pauldubois98/Morscipio/README.md

# Morscipio
Un decodeur de morse portable.

=> Prix "Innovez" dans le Sciences et Vie Junior (SVJ) n°329

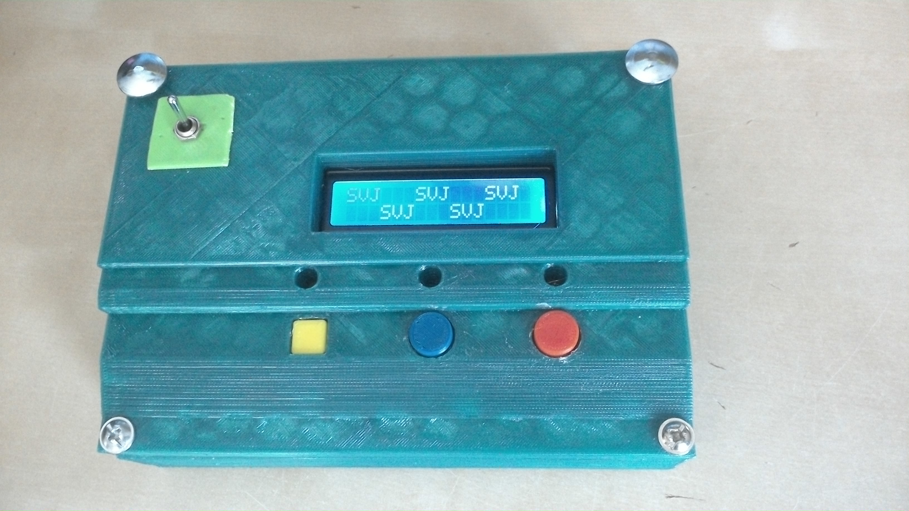
[picture p1: Fini/01.jpg]
final
