pauldubois98/Morscipio/Boitier/Bas0.jpg

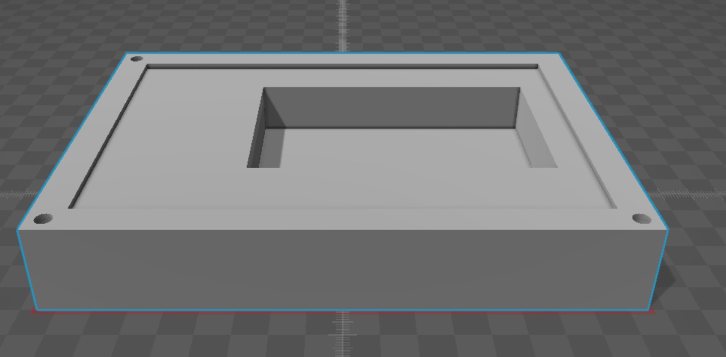
Boitier/Bas0.jpg
