pauldubois98/Morscipio/Boitier/Bas1.jpg

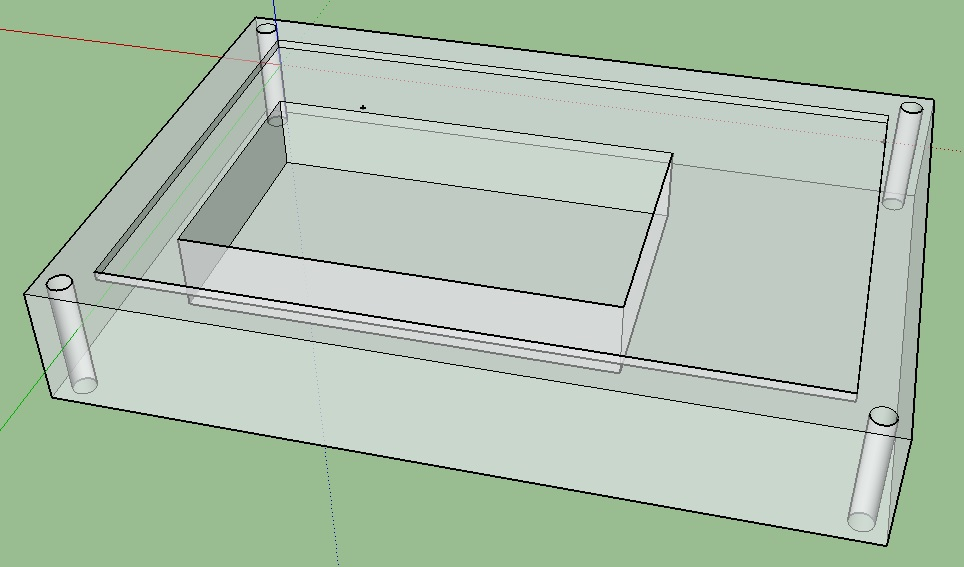
Boitier/Bas1.jpg
