pauldubois98/Morscipio/Boitier/Haut0.jpg

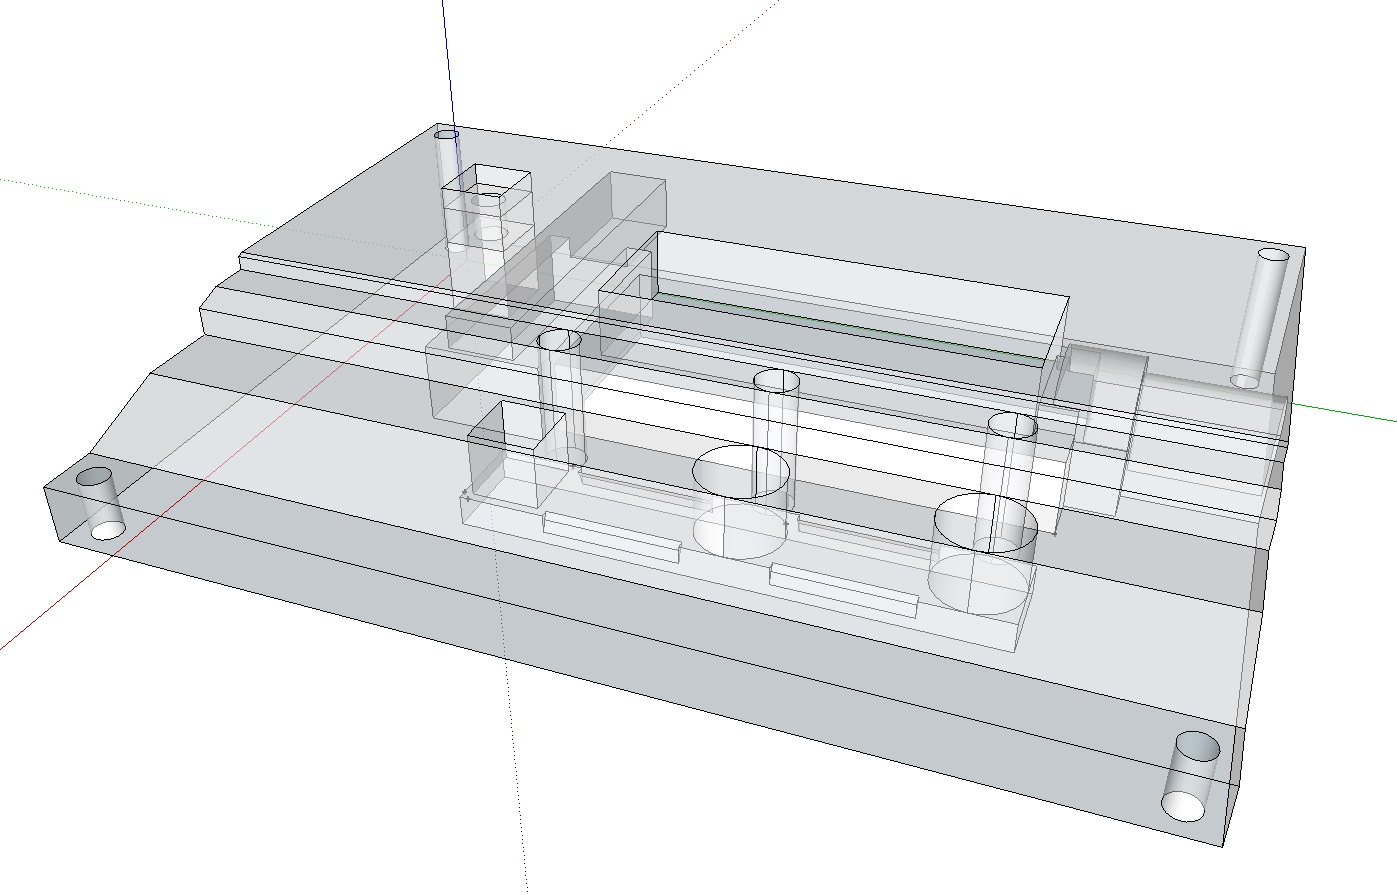
Boitier/Haut0.jpg
