pauldubois98/Morscipio/Boitier/Haut1.jpg

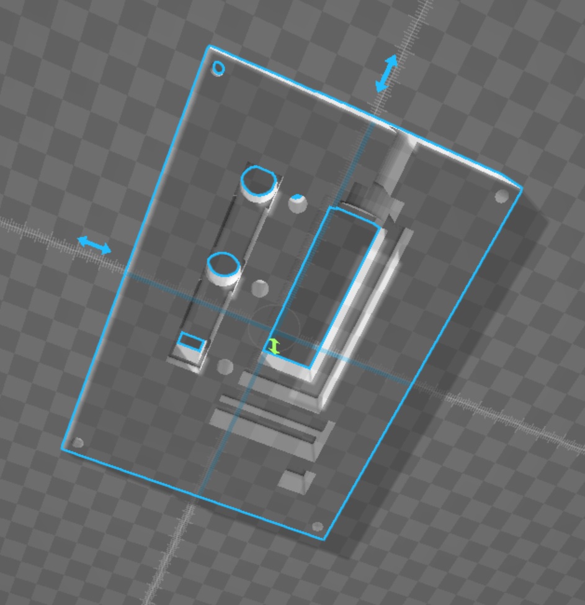
Boitier/Haut1.jpg
