pauldubois98/Morscipio/Boitier/Haut2.jpg

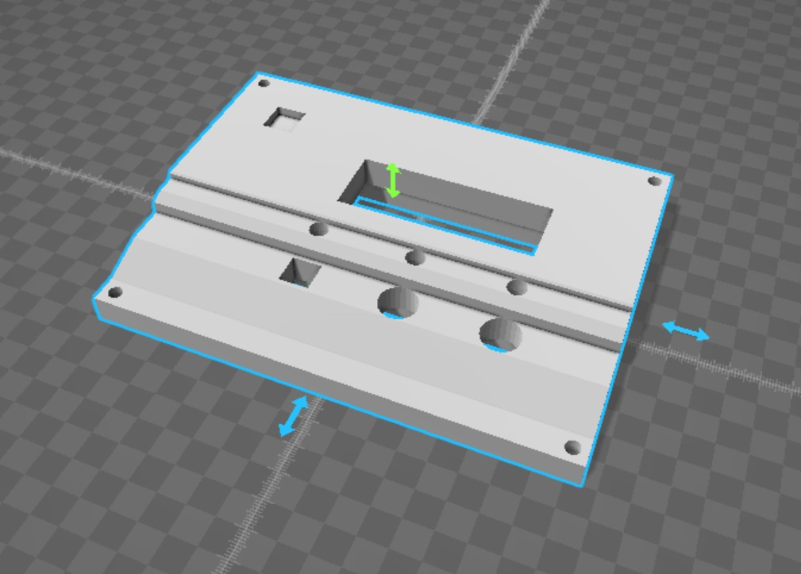
Boitier/Haut2.jpg
