pauldubois98/Morscipio/Coposants/Barrettes0.jpg

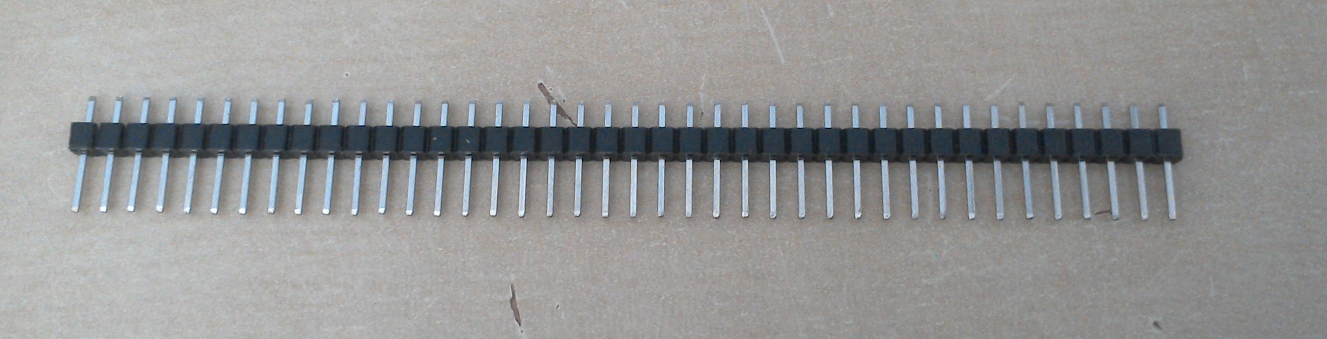
Coposants/Barrettes0.jpg
