pauldubois98/Morscipio/Coposants/Barrettes1.jpg

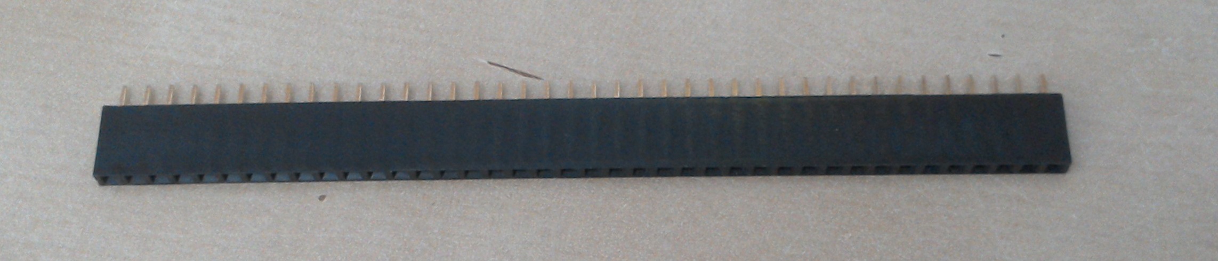
Coposants/Barrettes1.jpg
