pauldubois98/Morscipio/Coposants/BoitierPiles.jpg

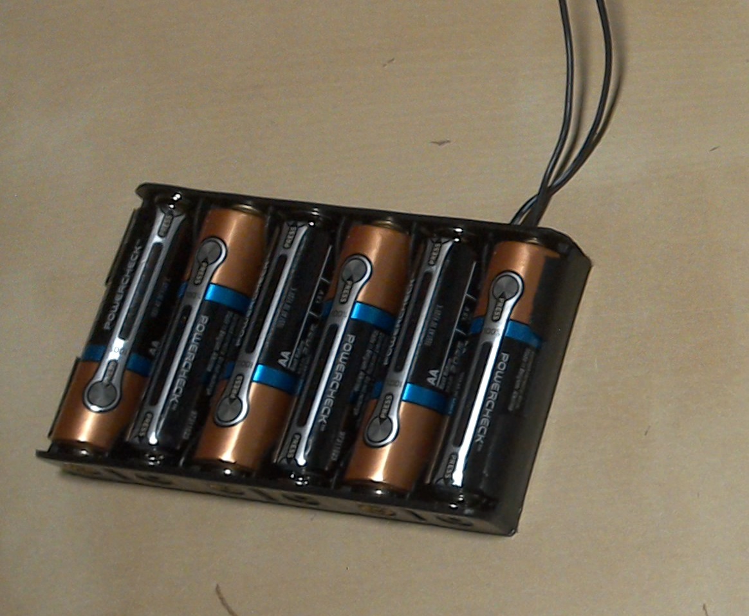
Coposants/BoitierPiles.jpg
