pauldubois98/Morscipio/Coposants/Bouton.jpg

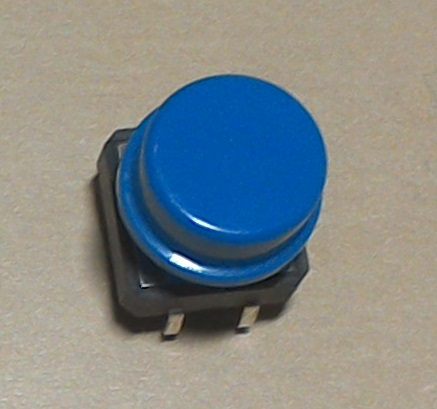
Coposants/Bouton.jpg
