pauldubois98/Morscipio/Coposants/BoutonONOFF.jpg

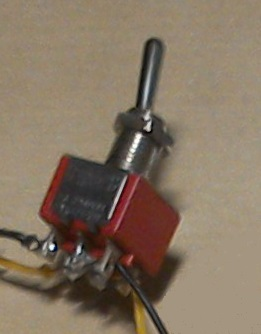
Coposants/BoutonONOFF.jpg
