pauldubois98/Morscipio/Coposants/Capacité10µ.jpg

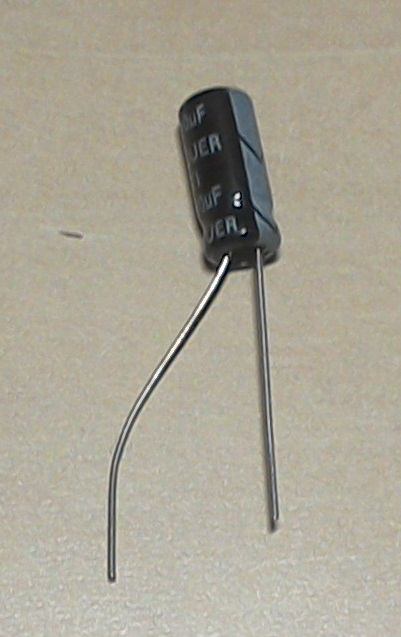
Coposants/Capacité10µ.jpg
