pauldubois98/Morscipio/Coposants/EcranLCD0.jpg

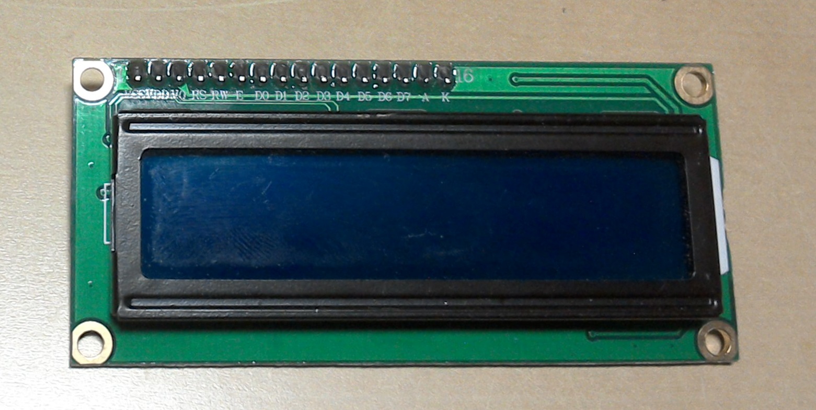
Coposants/EcranLCD0.jpg
