pauldubois98/Morscipio/Coposants/EcranLCD1.jpg

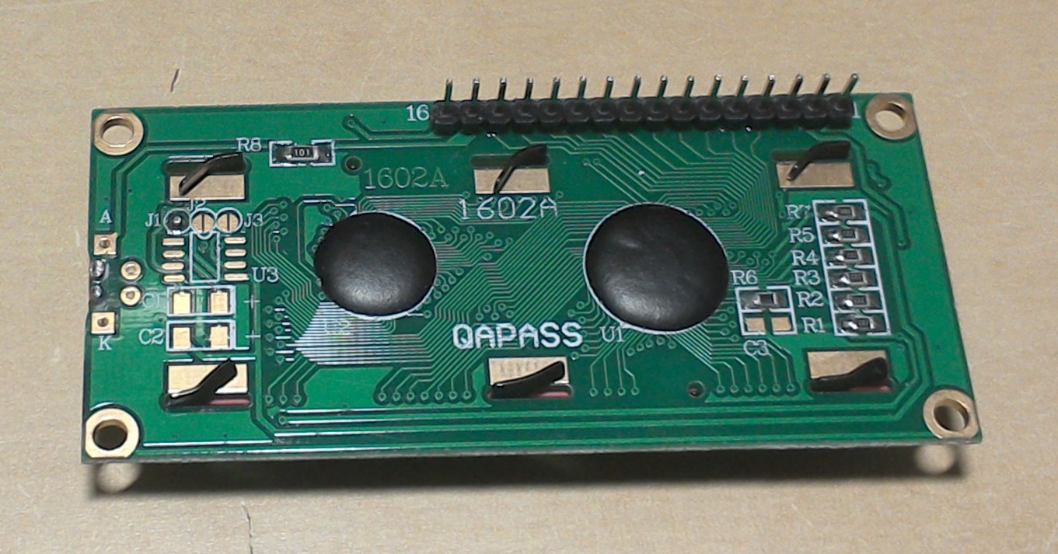
Coposants/EcranLCD1.jpg
