pauldubois98/Morscipio/Coposants/Fil.jpg

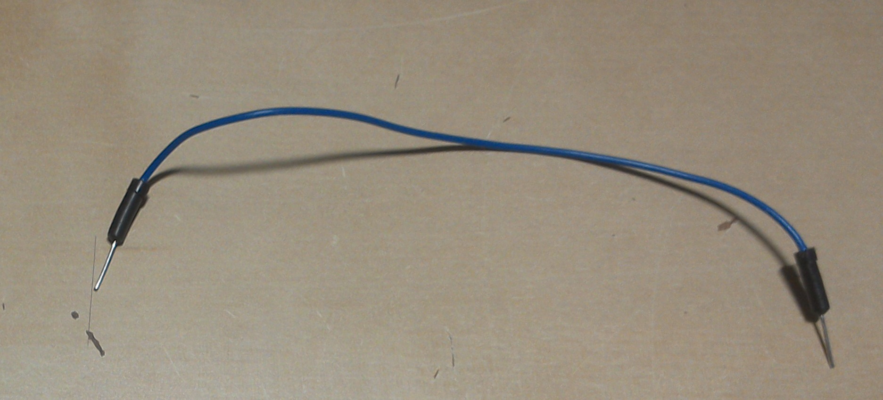
Coposants/Fil.jpg
