pauldubois98/Morscipio/Coposants/LED.jpg

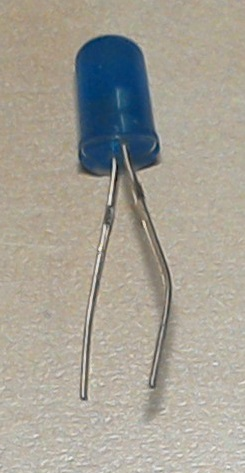
Coposants/LED.jpg
