pauldubois98/Morscipio/Coposants/Nano0.jpg

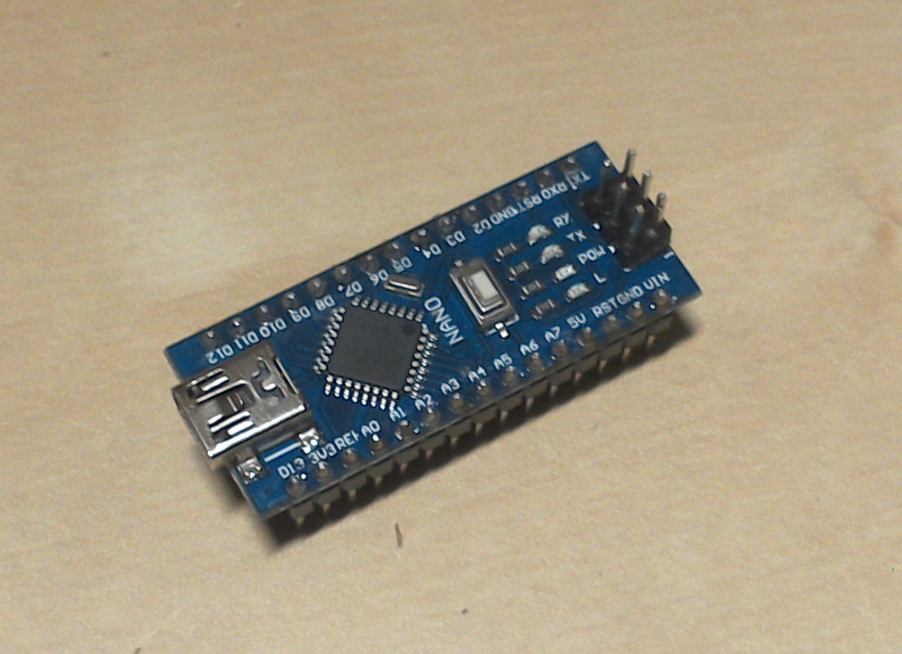
Coposants/Nano0.jpg
