pauldubois98/Morscipio/Coposants/Nano1.jpg

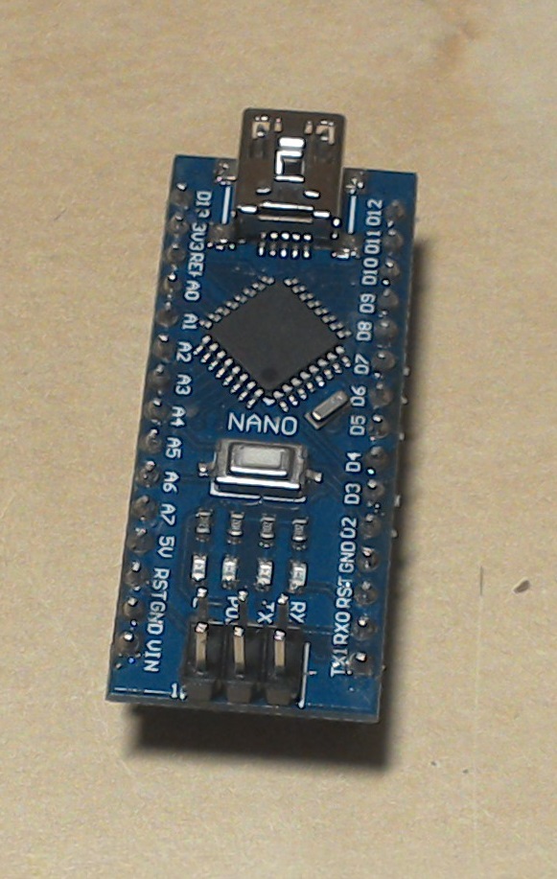
Coposants/Nano1.jpg
