pauldubois98/Morscipio/Coposants/Nano2.jpg

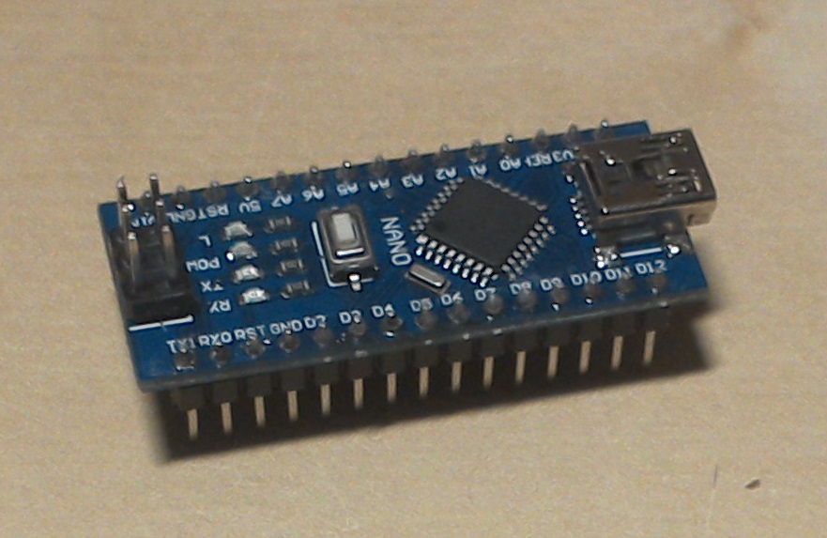
Coposants/Nano2.jpg
