pauldubois98/Morscipio/Coposants/Potentiomètre10k.jpg

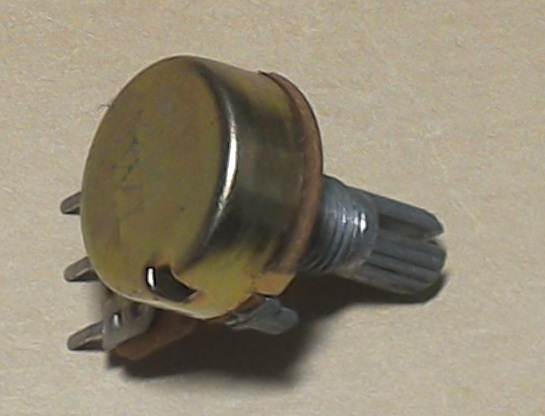
Coposants/Potentiomètre10k.jpg
