pauldubois98/Morscipio/Coposants/Resistance10k.jpg

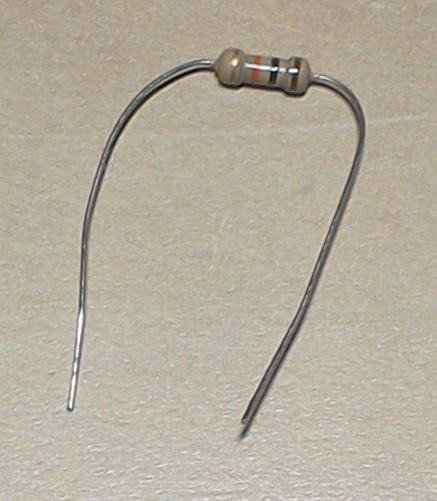
Coposants/Resistance10k.jpg
