pauldubois98/Morscipio/Coposants/Resistance330.jpg

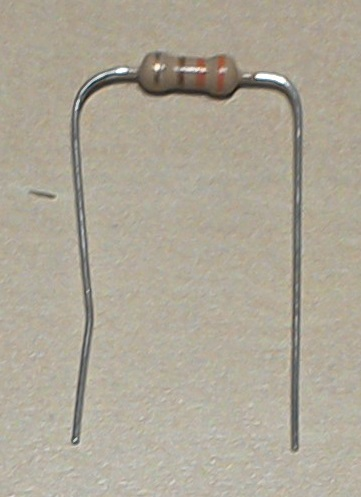
Coposants/Resistance330.jpg
