pauldubois98/Morscipio/Fini/02.jpg

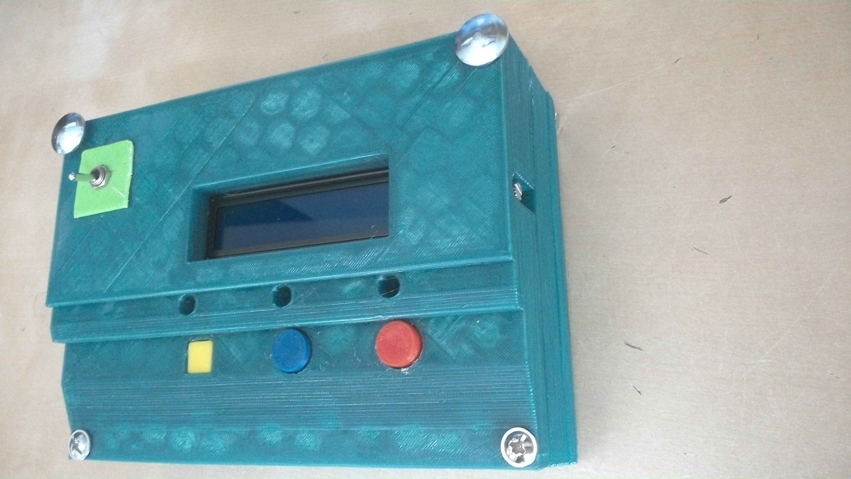
Fini/02.jpg
