pauldubois98/Morscipio/Fini/03.jpg

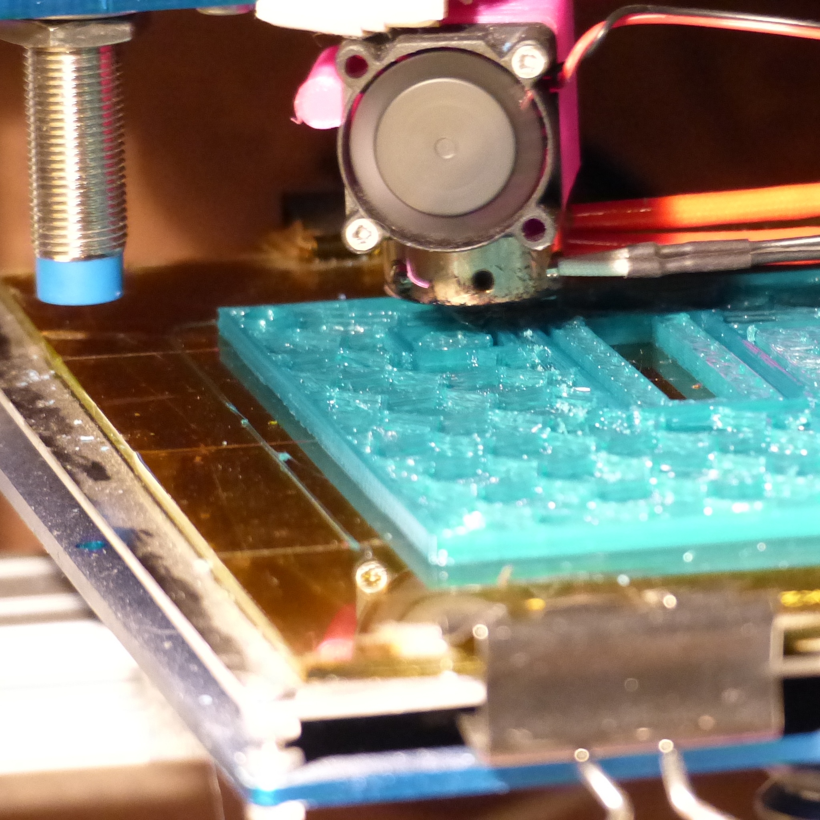
Fini/03.jpg
