pauldubois98/Morscipio/Fini/07.JPG

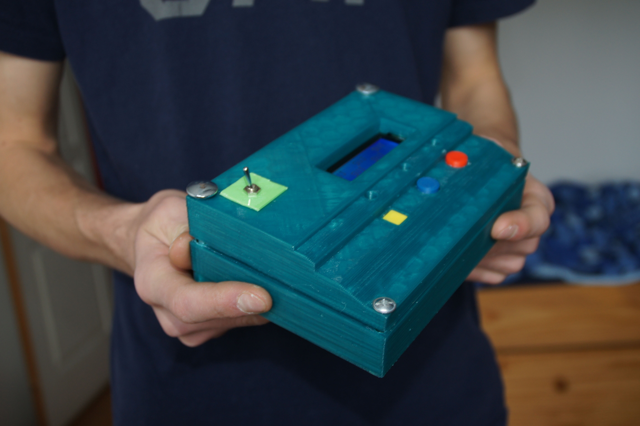
Fini/07.JPG
