pauldubois98/Morscipio/Fini/09.JPG

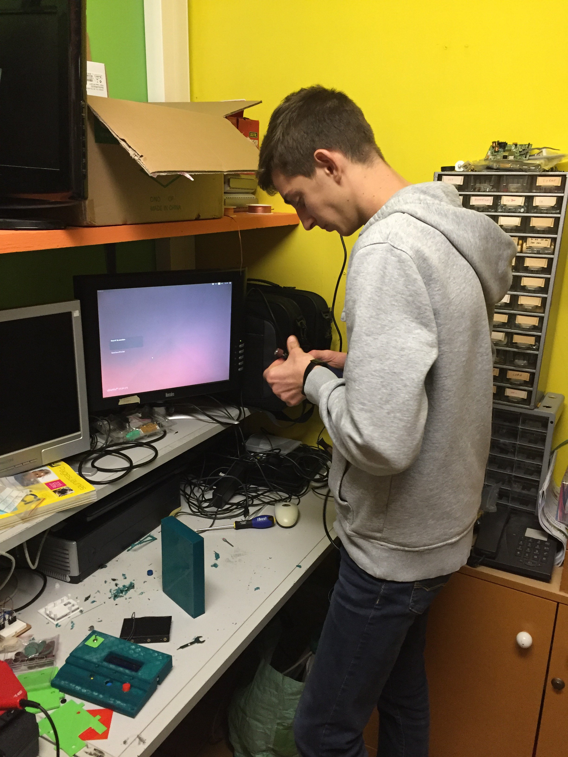
Fini/09.JPG
