pauldubois98/Morscipio/Fini/10.JPG

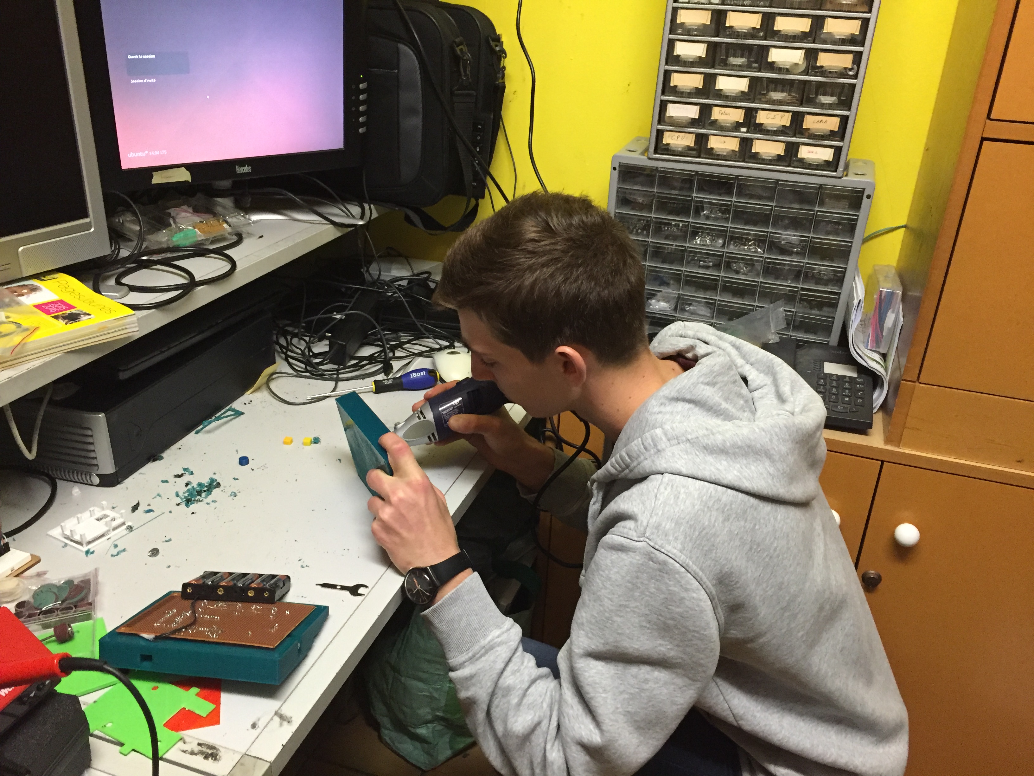
Fini/10.JPG
