pauldubois98/Morscipio/Fini/11.JPG

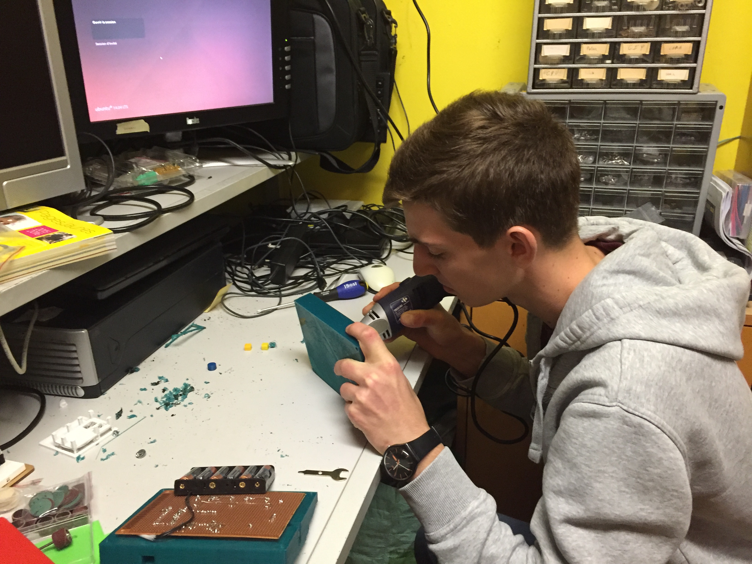
Fini/11.JPG
