pauldubois98/Morscipio/Morscipio0.jpg

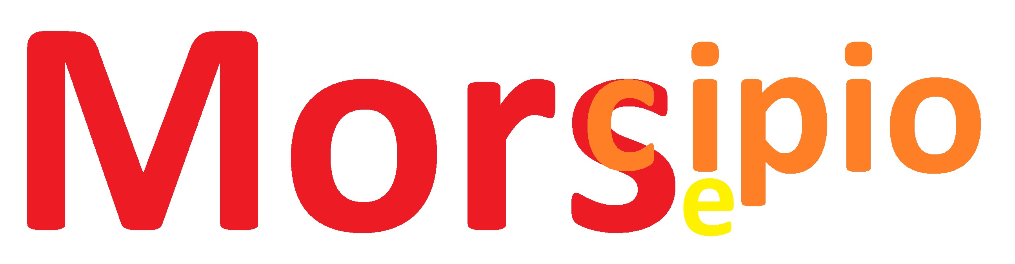
Morscipio0.jpg
