pauldubois98/Morscipio/Schémas/CircuitBoutonAnti-Rebond.jpg

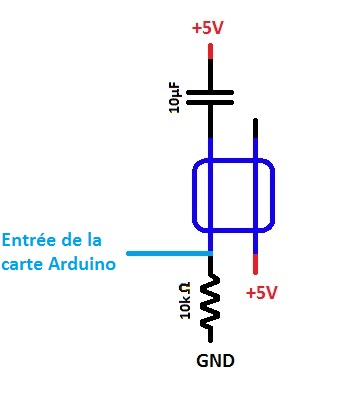
Schémas/CircuitBoutonAnti-Rebond.jpg
