pauldubois98/Morscipio/Schémas/CircuitBoutonRebond.jpg

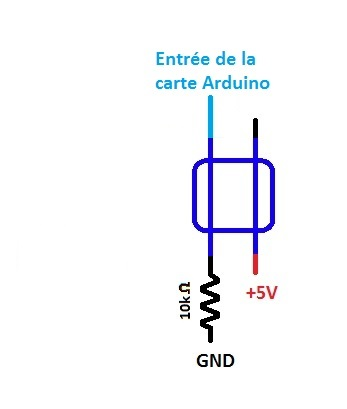
Schémas/CircuitBoutonRebond.jpg
