pauldubois98/Morscipio/Schémas/L'affichage.jpg

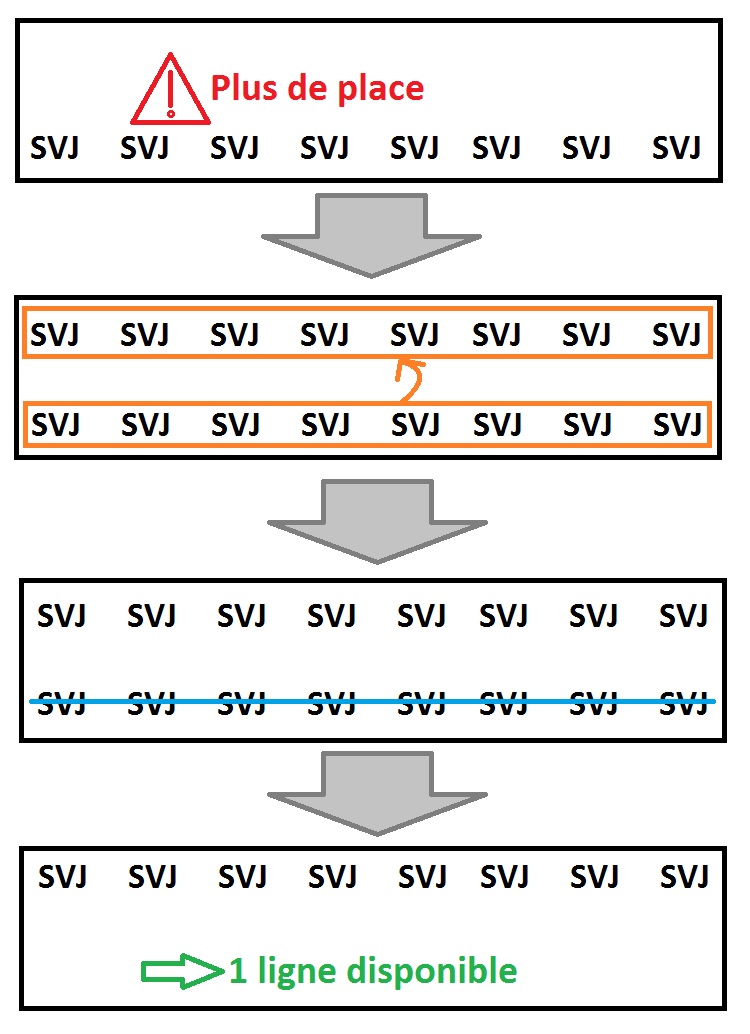
Schémas/L'affichage.jpg
