pauldubois98/Morscipio/Schémas/Le code.jpg

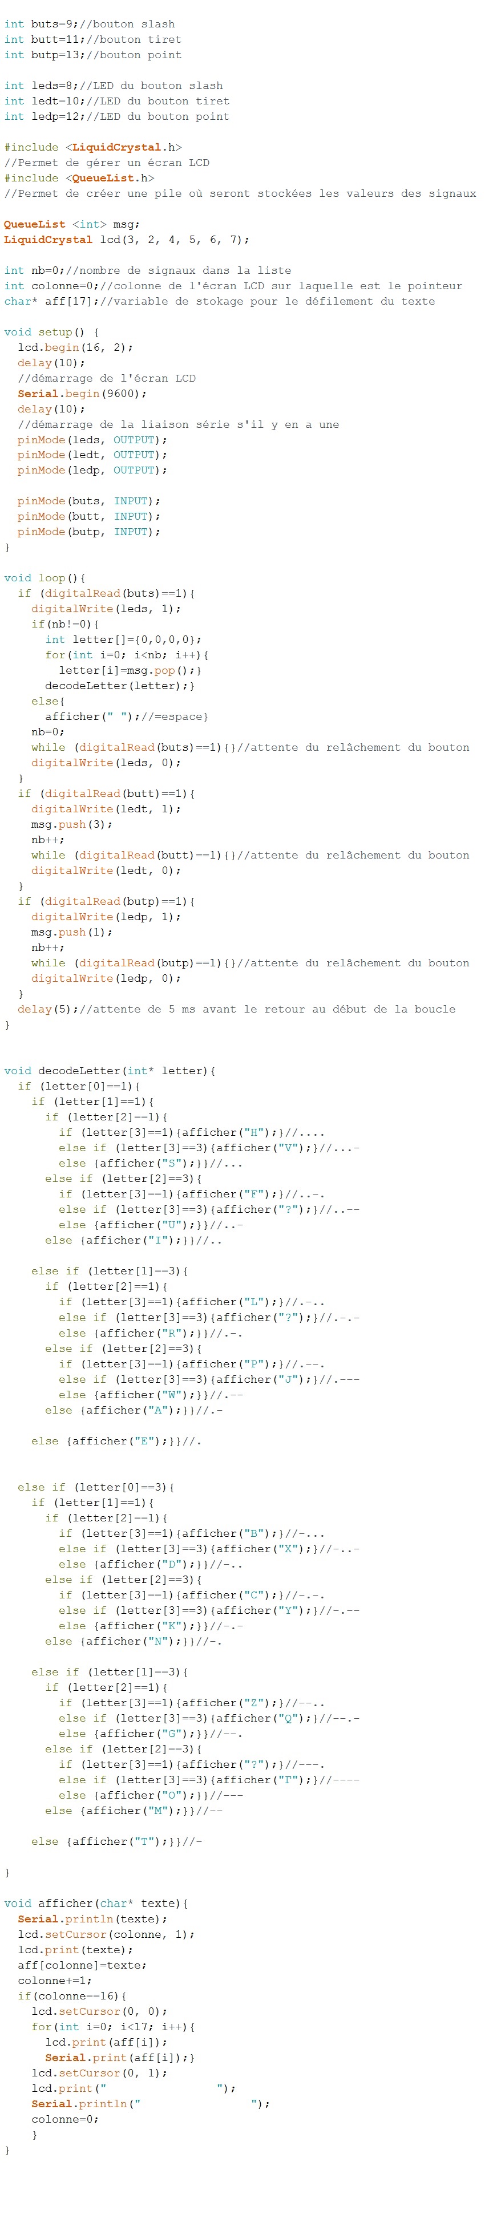
Schémas/Le code.jpg
