pauldubois98/Morscipio/Schémas/Morse Alphabet.jpg

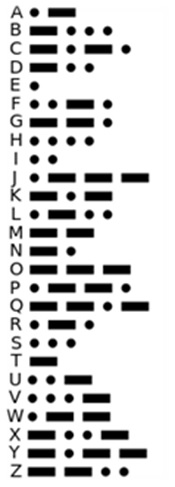
Schémas/Morse Alphabet.jpg
