pauldubois98/Morscipio/Schémas/Morse Arbre.jpg

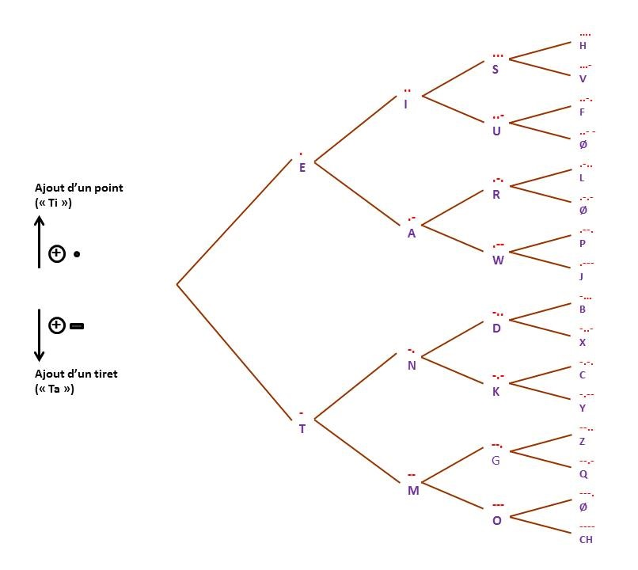
Schémas/Morse Arbre.jpg
