pauldubois98/Morscipio/Schémas/SchemaSoudure0.jpg

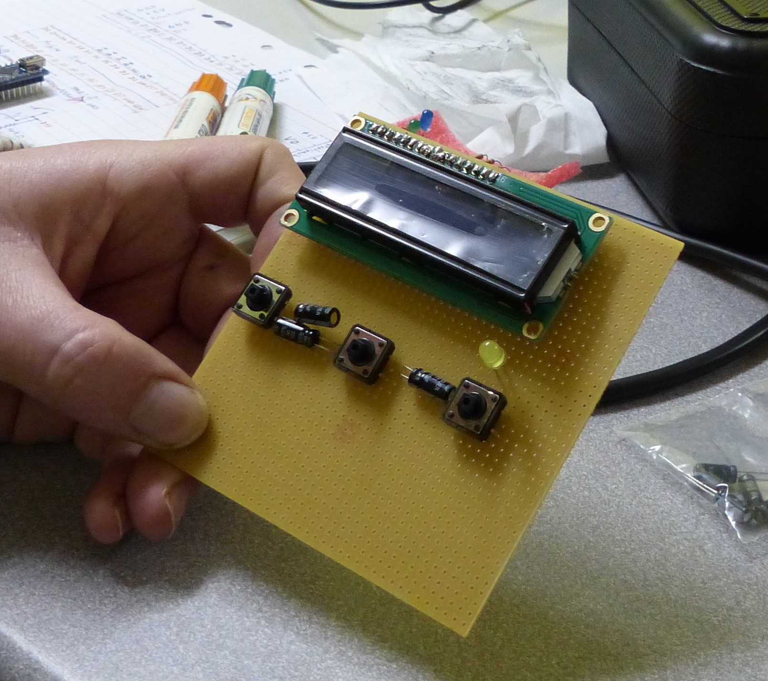
Schémas/SchemaSoudure0.jpg
