pauldubois98/Morscipio/Schémas/SchemaSoudure1.jpg

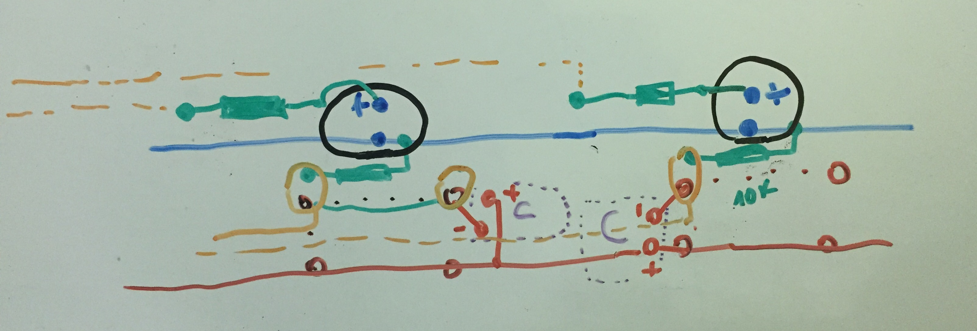
Schémas/SchemaSoudure1.jpg
