pauldubois98/Morscipio/Schémas/SchémaBoutonAnti-Rebond.jpg

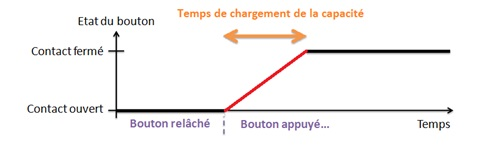
Schémas/SchémaBoutonAnti-Rebond.jpg
