pauldubois98/Morscipio/Schémas/SchémaBoutonRebond.jpg

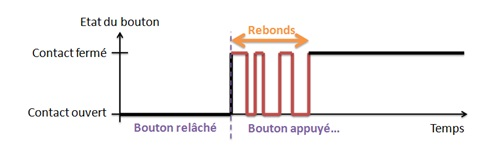
Schémas/SchémaBoutonRebond.jpg
