pauldubois98/Morscipio/Schémas/SchémaPapier.jpeg

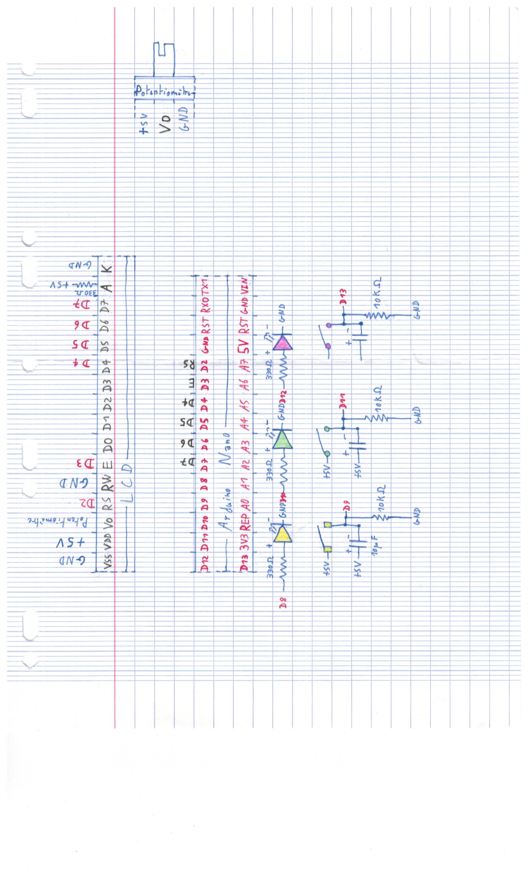
Schémas/SchémaPapier.jpeg
