pauldubois98/Morscipio/Boitier/Haut.stl

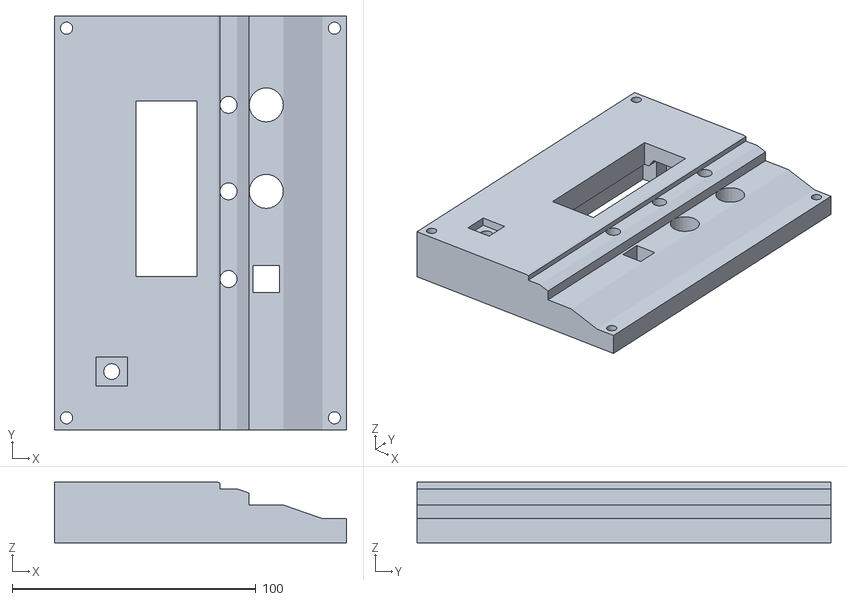
[picture p70: CAD file, 2018-10-07]
Boitier/Haut.stl
120.0 x 170.0 x 25.0
