pauldubois98/Morscipio/Boitier/Bas.stl

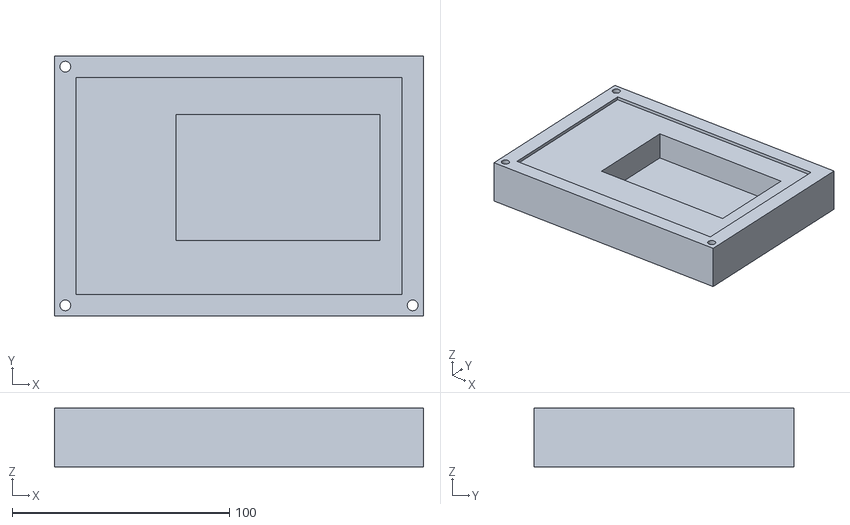
[picture p71: CAD file, 2018-10-07]
Boitier/Bas.stl
170.0 x 120.0 x 27.0
