pauldubois98/Morscipio/(list of files, cad)

Other CAD files:
Boitier/Bas.skp
Boitier/Haut.skp
