pauldubois98/Morscipio/Montages/MontageNANO0.jpg

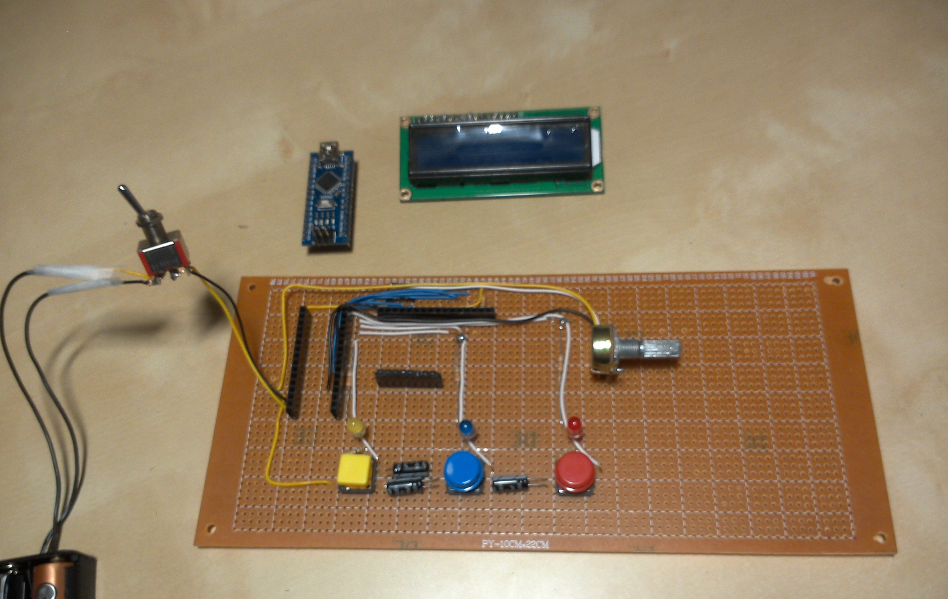
Montages/MontageNANO0.jpg
