pauldubois98/Morscipio/Montages/MontageNANO1.jpg

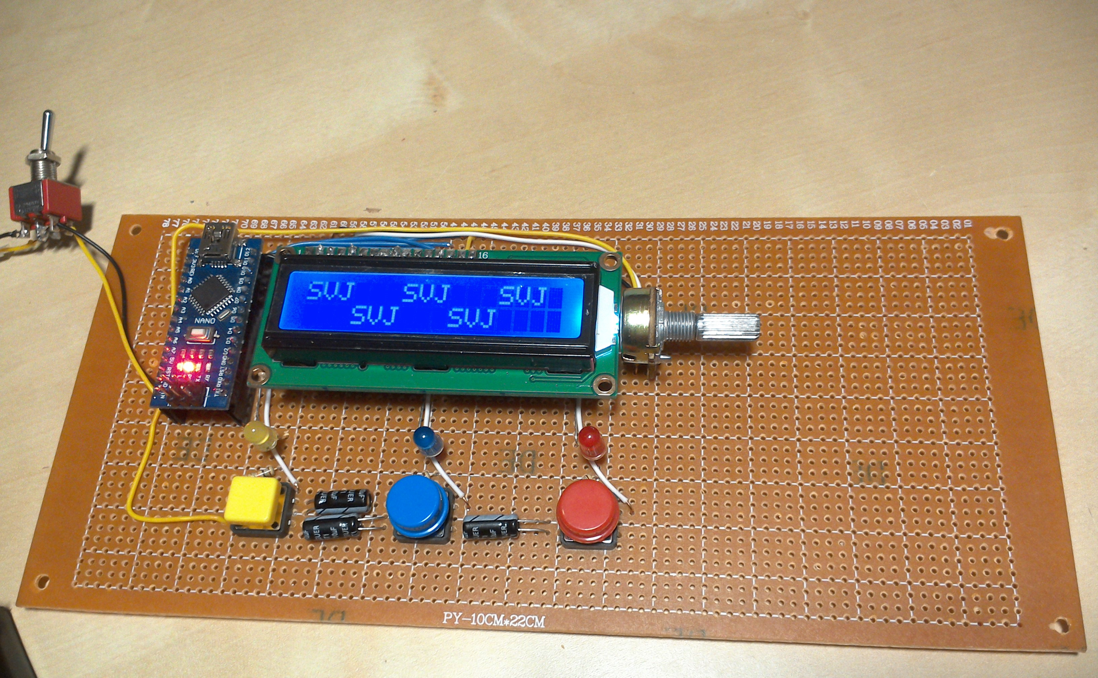
Montages/MontageNANO1.jpg
