pauldubois98/Morscipio/Montages/MontageNANO2.jpg

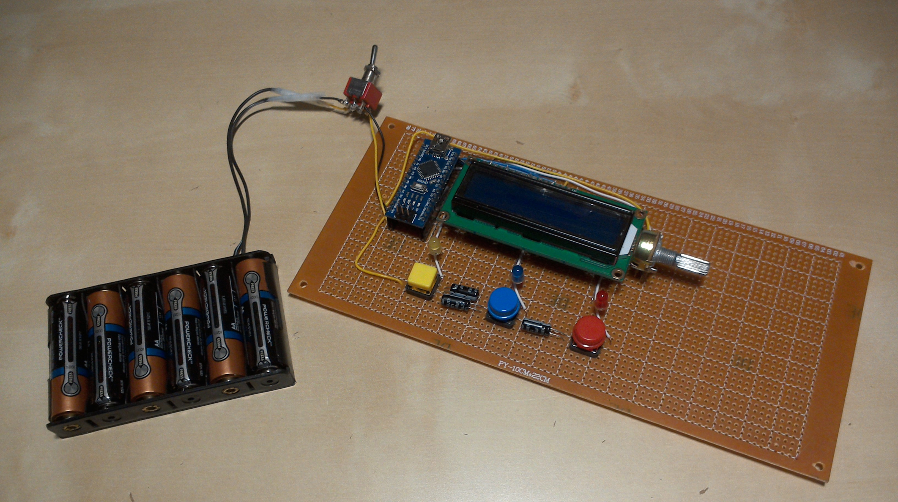
Montages/MontageNANO2.jpg
