pauldubois98/Morscipio/Montages/MontagePoly0.JPG

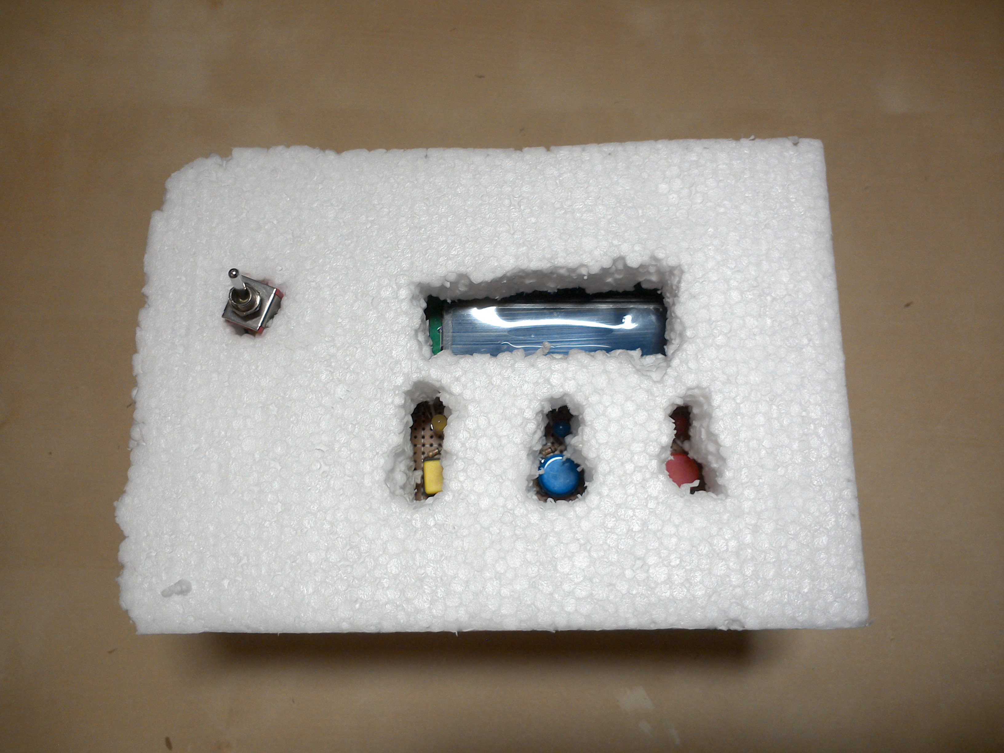
Montages/MontagePoly0.JPG
