pauldubois98/Morscipio/Montages/MontagePoly1.JPG

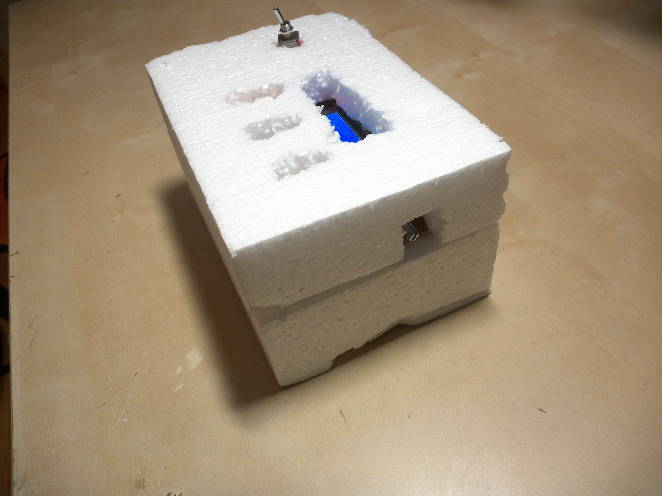
Montages/MontagePoly1.JPG
