pauldubois98/Morscipio/Montages/MontagePoly2.JPG

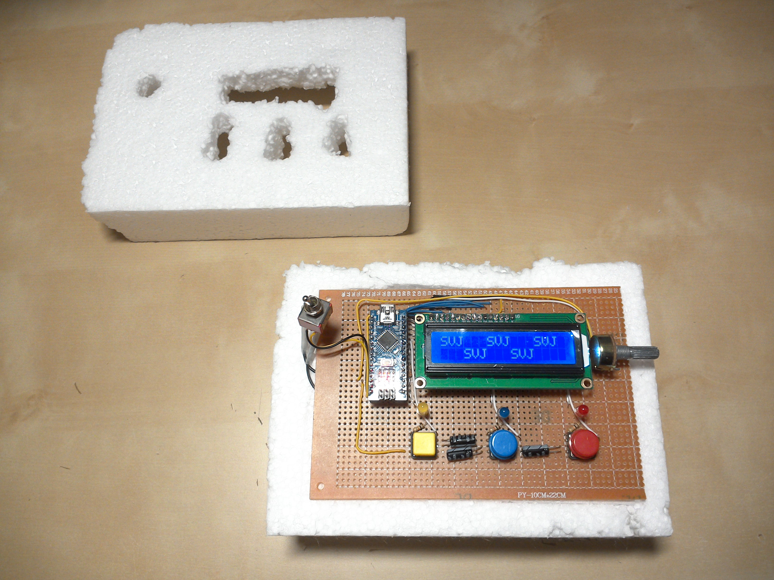
Montages/MontagePoly2.JPG
