pauldubois98/Morscipio/Montages/MontagePoly3.JPG

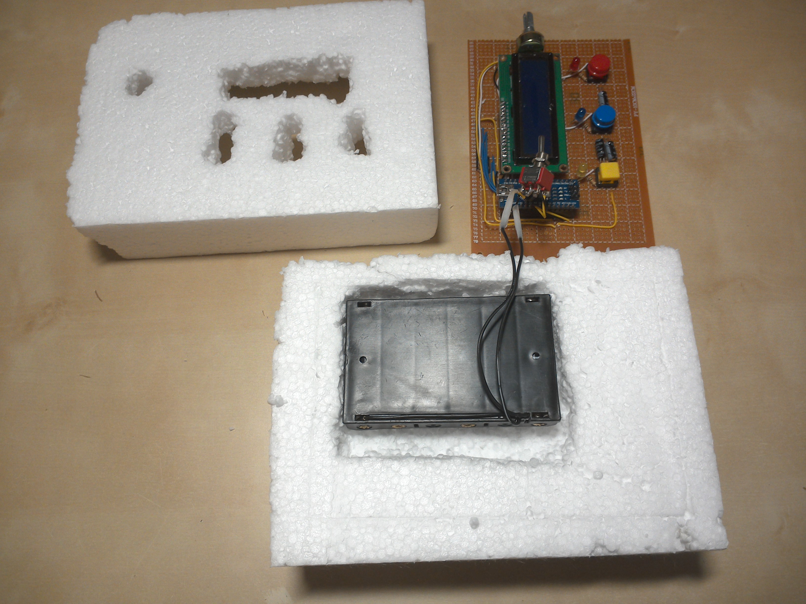
Montages/MontagePoly3.JPG
