pauldubois98/Morscipio/Montages/MontagePoly4.JPG

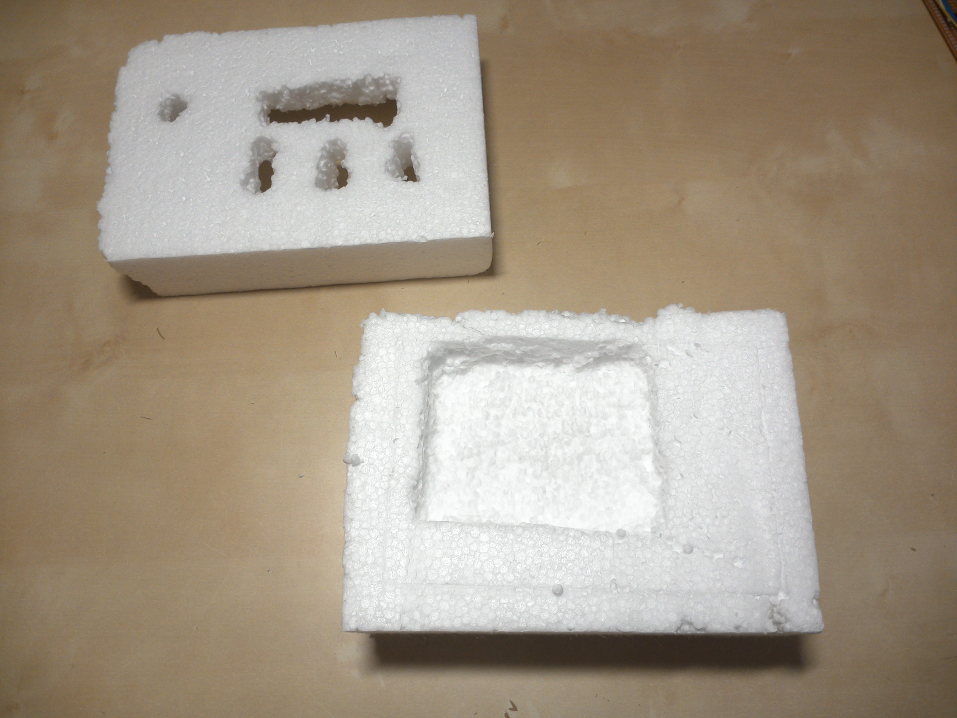
Montages/MontagePoly4.JPG
