pauldubois98/Morscipio/Montages/MontageUNO0.jpg

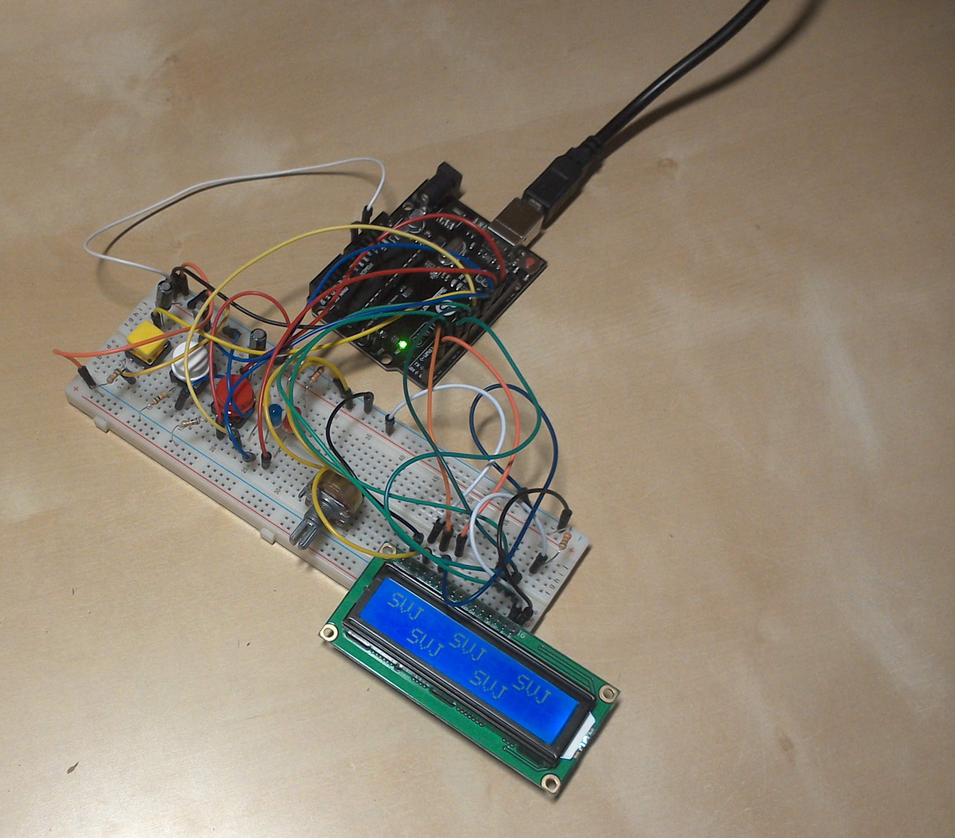
Montages/MontageUNO0.jpg
