pauldubois98/Morscipio/Montages/MontageUNO1.jpg

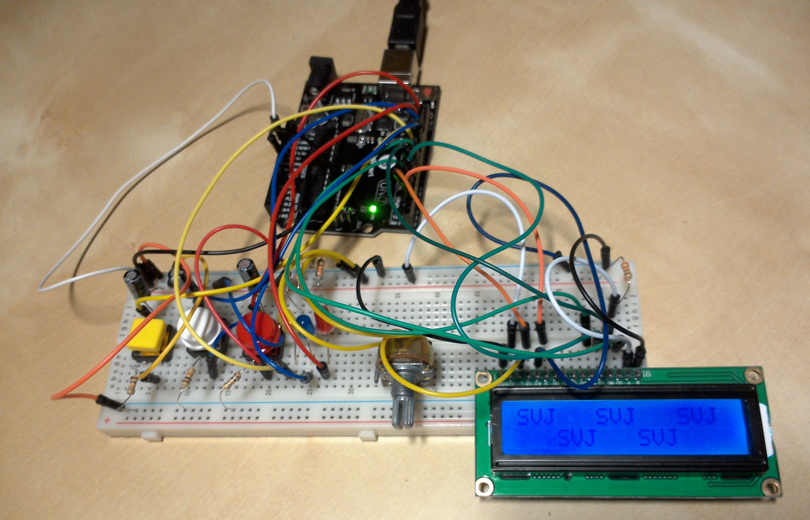
Montages/MontageUNO1.jpg
