pauldubois98/Morscipio/Fini/05.JPG

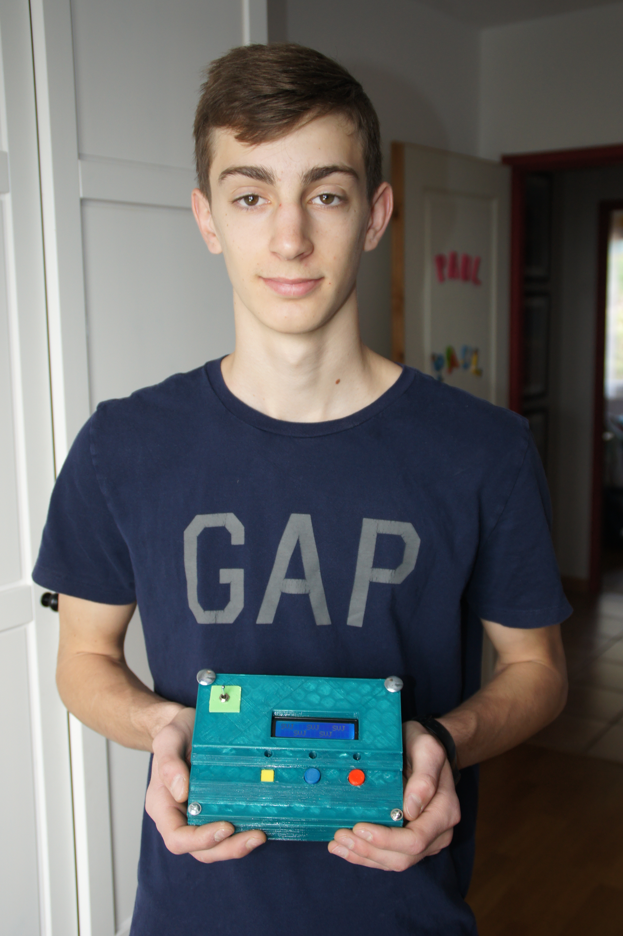
Fini/05.JPG
